sai-ydev/phd_HAT/PhD_HAT.brd

## EAGLE design PhD_HAT.brd (2019-10-11)

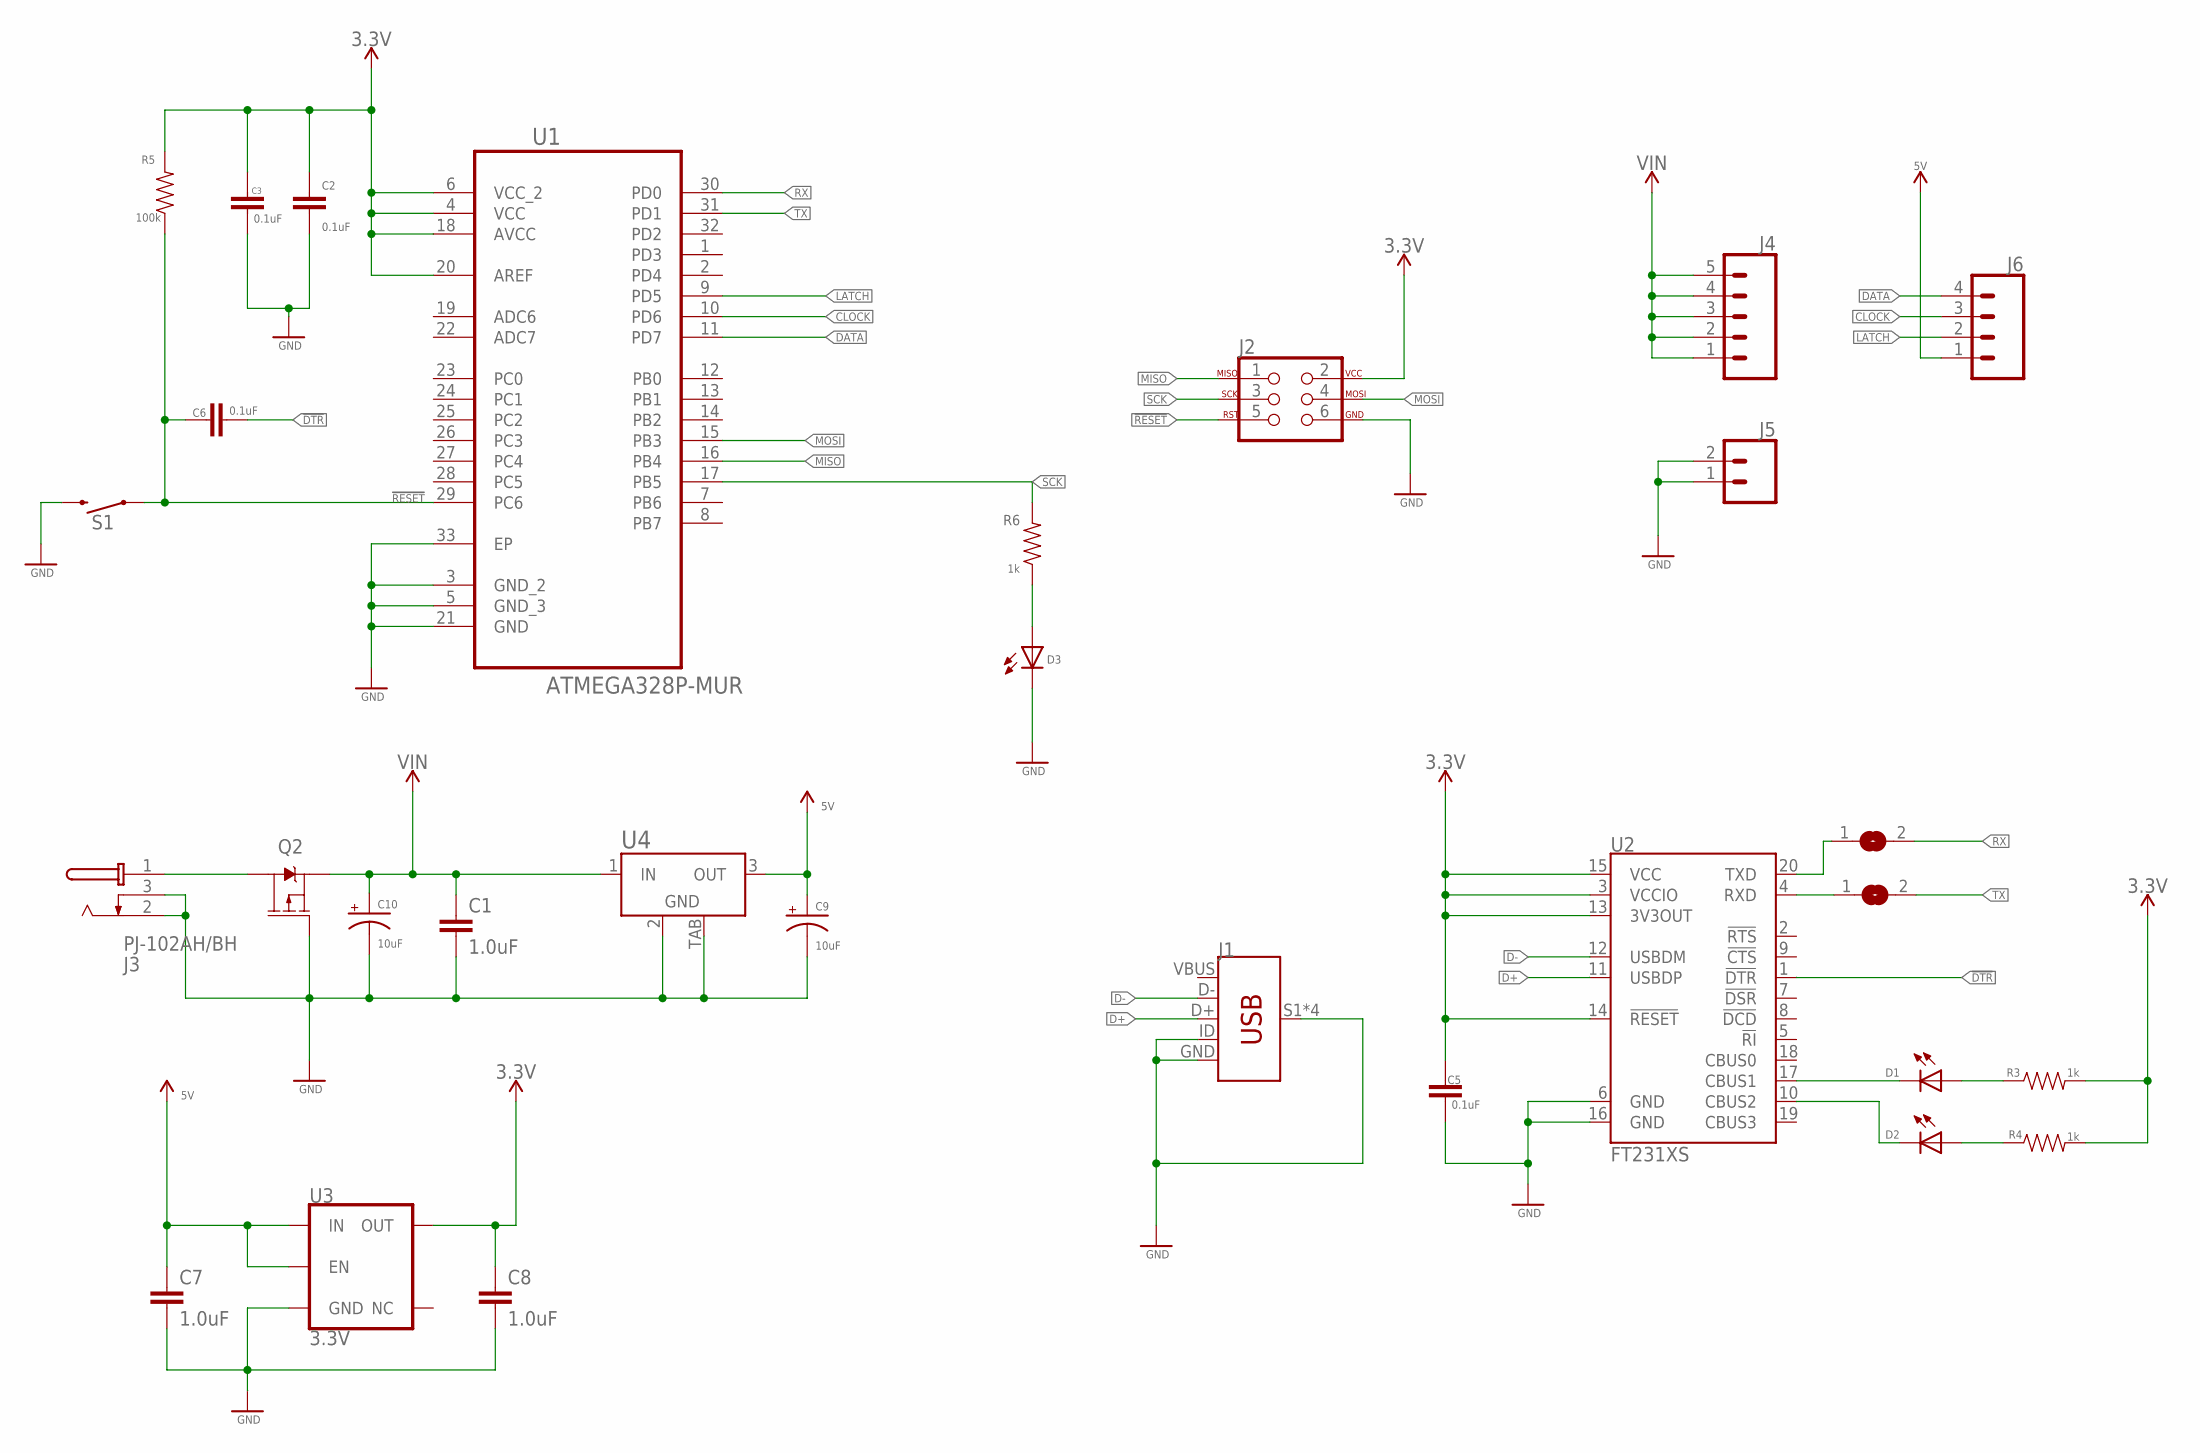
[picture p1: schematic PhD_HAT.sch, sheet 1]

Parts:
C1, C7, C8: 1.0uF; 0603
C2, C3, C5, C6: 0.1uF; 0603
C9, C10: 10uF; EIA3216
D1, D2, D3: LEDCHIP-LED0603; CHIP-LED0603
J1: USB_MINI-B_SMT; USB-MINIB
J2: AVR_SPI_PROG_3X2PTH; 2X3
J3: PJ-102AH/BH; PJ-102XH
J4: CONN_05SCREW; SCREWTERMINAL-3.5MM-5
J5: CONN_023.5MM; SCREWTERMINAL-3.5MM-2
J6: CONN_04SCREW; SCREWTERMINAL-3.5MM-4
Q2: 2.5A/30V/105mΩ; SOT23-3
R3, R4, R6: 1k; 0603
R5: 100k; 0603
S1: MOMENTARY-SWITCH-SPST-PTH-6.0MM; TACTILE_SWITCH_PTH_6.0MM
SJ1, SJ2: MICROBUILDER_SOLDERJUMPERREFLOW; MICROBUILDER_SOLDERJUMPER_REFLOW
U1: ATMEGA328P-MUR; QFN50P500X500X100-33N
U2: FT231XS; SSOP20_L
U3: 3.3V; SOT23-5
U4: MIC39100-5.0WS; SOT223

Connections:
3.3V: C2.1, C3.1, C5.1, C8.1, J2.2, R3.2, R4.2, R5.2, U1.4 (VCC), U1.6 (VCC_2), U1.18 (AVCC), U1.20 (AREF), U2.3 (VCCIO), U2.13 (3V3OUT), U2.14 (!RESET), U2.15 (VCC), U3.5 (OUT)
5V: C7.1, C9.+, J6.1, U3.1 (IN), U3.3 (EN), U4.3 (OUT)
!DTR: C6.2, U2.1 (!DTR)
!RESET: C6.1, J2.5, R5.1, S1.1, U1.29 (PC6)
CLOCK: J6.3, U1.10 (PD6)
D+: J1.D+, U2.11 (USBDP)
D-: J1.D-, U2.12 (USBDM)
DATA: J6.4, U1.11 (PD7)
GND: C1.2, C2.2, C3.2, C5.2, C7.2, C8.2, C9.-, C10.-, D3.C, J1.GND, J1.ID, J1.S1 (SHIELD), J1.S2 (SHIELD), J1.S3 (SHIELD), J1.S4 (SHIELD), J2.6, J3.2 (S), J3.3 (SS), J5.1, J5.2, Q2.1 (G), S1.3 (2), U1.3 (GND_2), U1.5 (GND_3), U1.21 (GND), U1.33 (EP), U2.6 (GND), U2.16 (GND), U3.2 (GND), U4.2 (GND), U4.TAB (GND); also elsewhere on the board
LATCH: J6.2, U1.9 (PD5)
MISO: J2.1, U1.16 (PB4)
MOSI: J2.4, U1.15 (PB3)
unnamed: D1.C, U2.17 (CBUS1)
unnamed: D2.C, U2.10 (CBUS2)
unnamed: D1.A, R3.1
unnamed: D2.A, R4.1
unnamed: D3.A, R6.1
unnamed: SJ1.1, U2.4 (RXD)
unnamed: SJ2.1, U2.20 (TXD)
unnamed: J3.1 (T), Q2.3 (D)
RX: SJ2.2, U1.30 (PD0); also elsewhere on the board
SCK: J2.3, R6.2, U1.17 (PB5)
TX: SJ1.2, U1.31 (PD1); also elsewhere on the board
VBUS: J1.VBUS
VIN: C1.1, C10.+, J4.1, J4.2, J4.3, J4.4, J4.5, Q2.2 (S), U4.1 (IN)

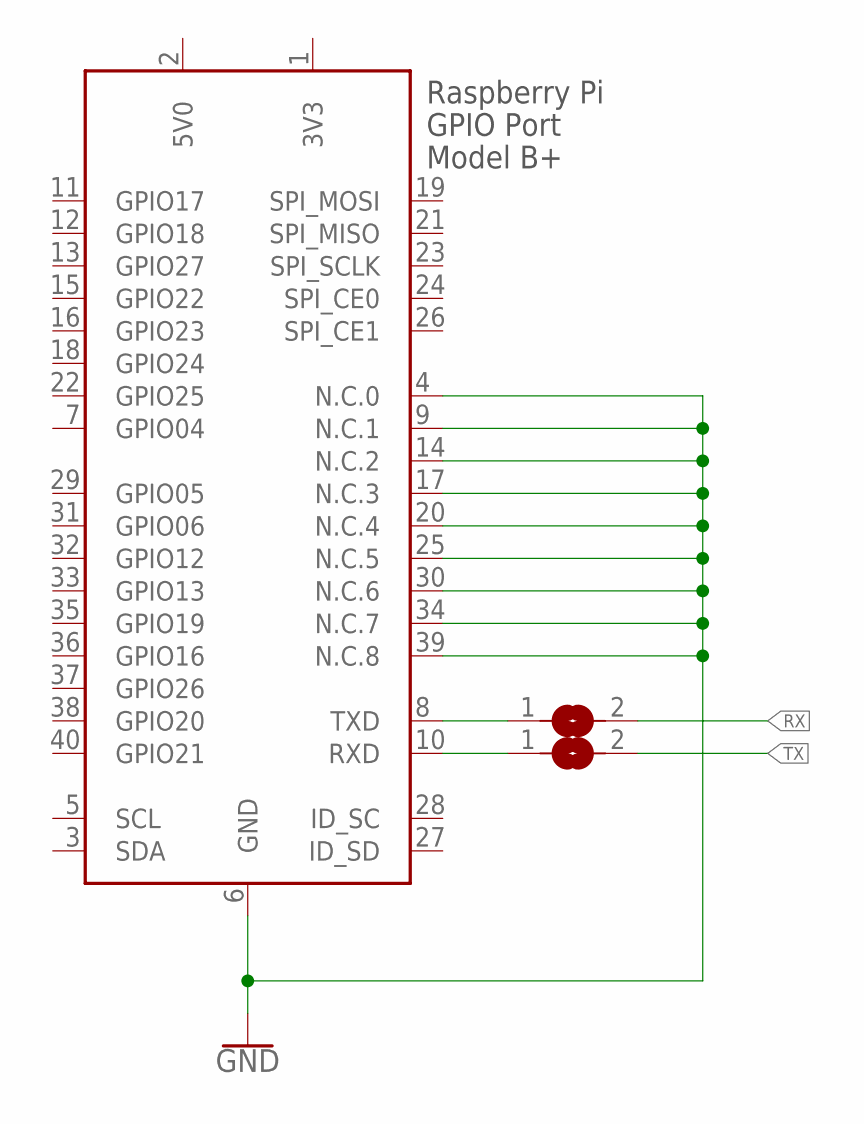
[picture p2: schematic PhD_HAT.sch, sheet 2]

Parts:
SJ3, SJ4: MICROBUILDER_SOLDERJUMPER; MICROBUILDER_SOLDERJUMPER_ARROW_NOPASTE
X1: RASPI_BOARD_B+_H; RASPI_BOARD_B+HAT

Connections:
3V3: X1.1 (3V3)
5V0: X1.2 (5V0)
GND: X1.4 (N.C.0), X1.6 (GND), X1.9 (N.C.1), X1.14 (N.C.2), X1.17 (N.C.3), X1.20 (N.C.4), X1.25 (N.C.5), X1.30 (N.C.6), X1.34 (N.C.7), X1.39 (N.C.8); also elsewhere on the board
unnamed: SJ3.1, X1.8 (TXD)
unnamed: SJ4.1, X1.10 (RXD)
RX: SJ3.2; also elsewhere on the board
TX: SJ4.2; also elsewhere on the board

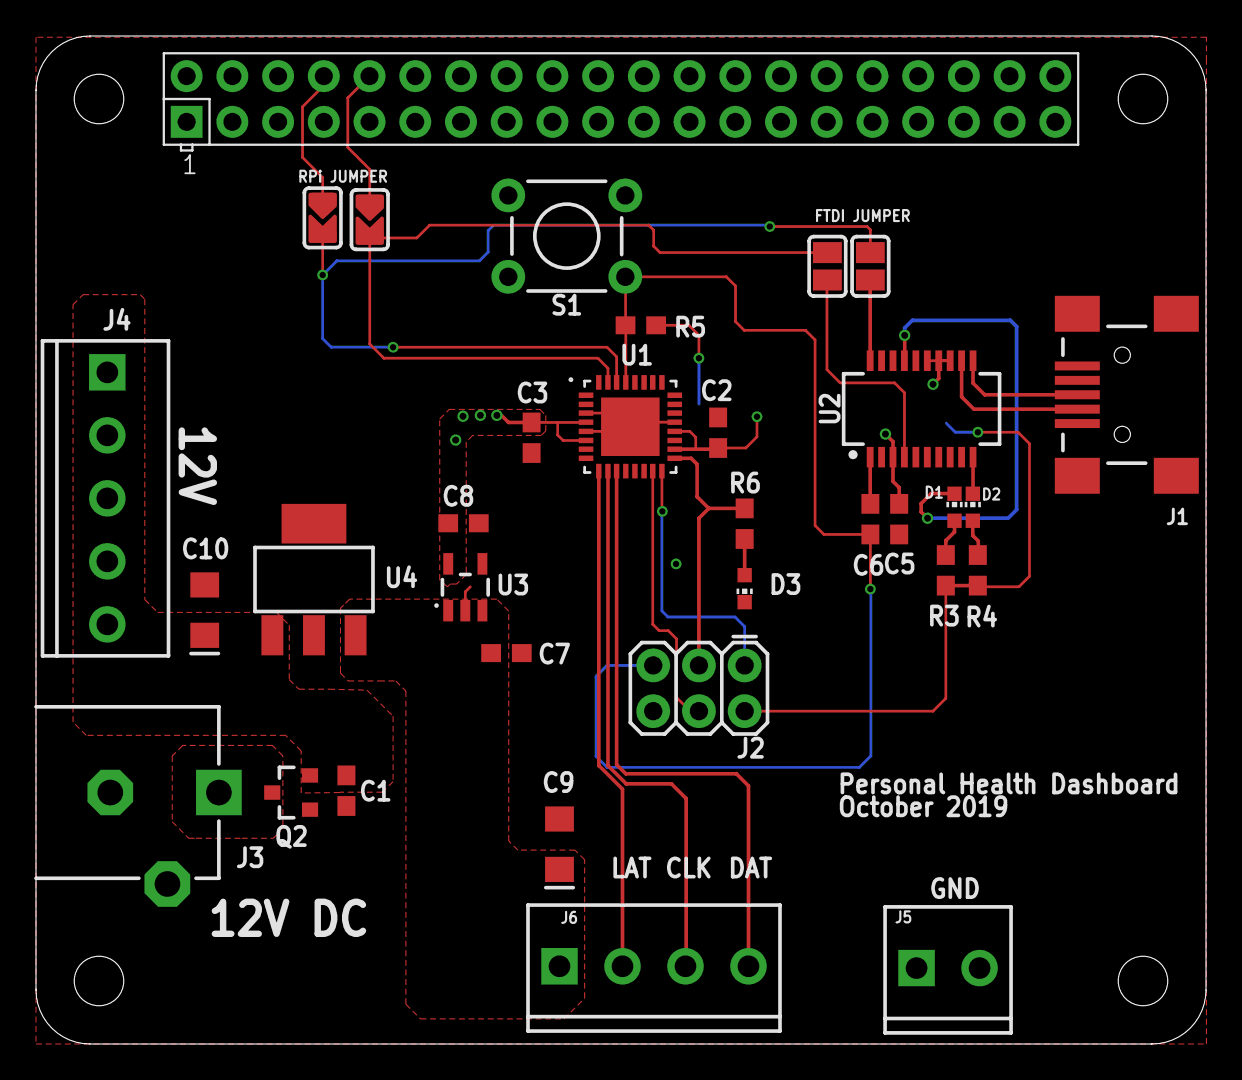
[picture p3: board PhD_HAT.brd from above]

Board: 2 copper layers, 65.0 x 56.0 mm, 33 parts (0 on the bottom side), 26 nets.
