sai-ydev/phd_HAT/PhD_HAT_Pi.brd

## EAGLE design PhD_HAT_Pi.brd (2019-10-04)

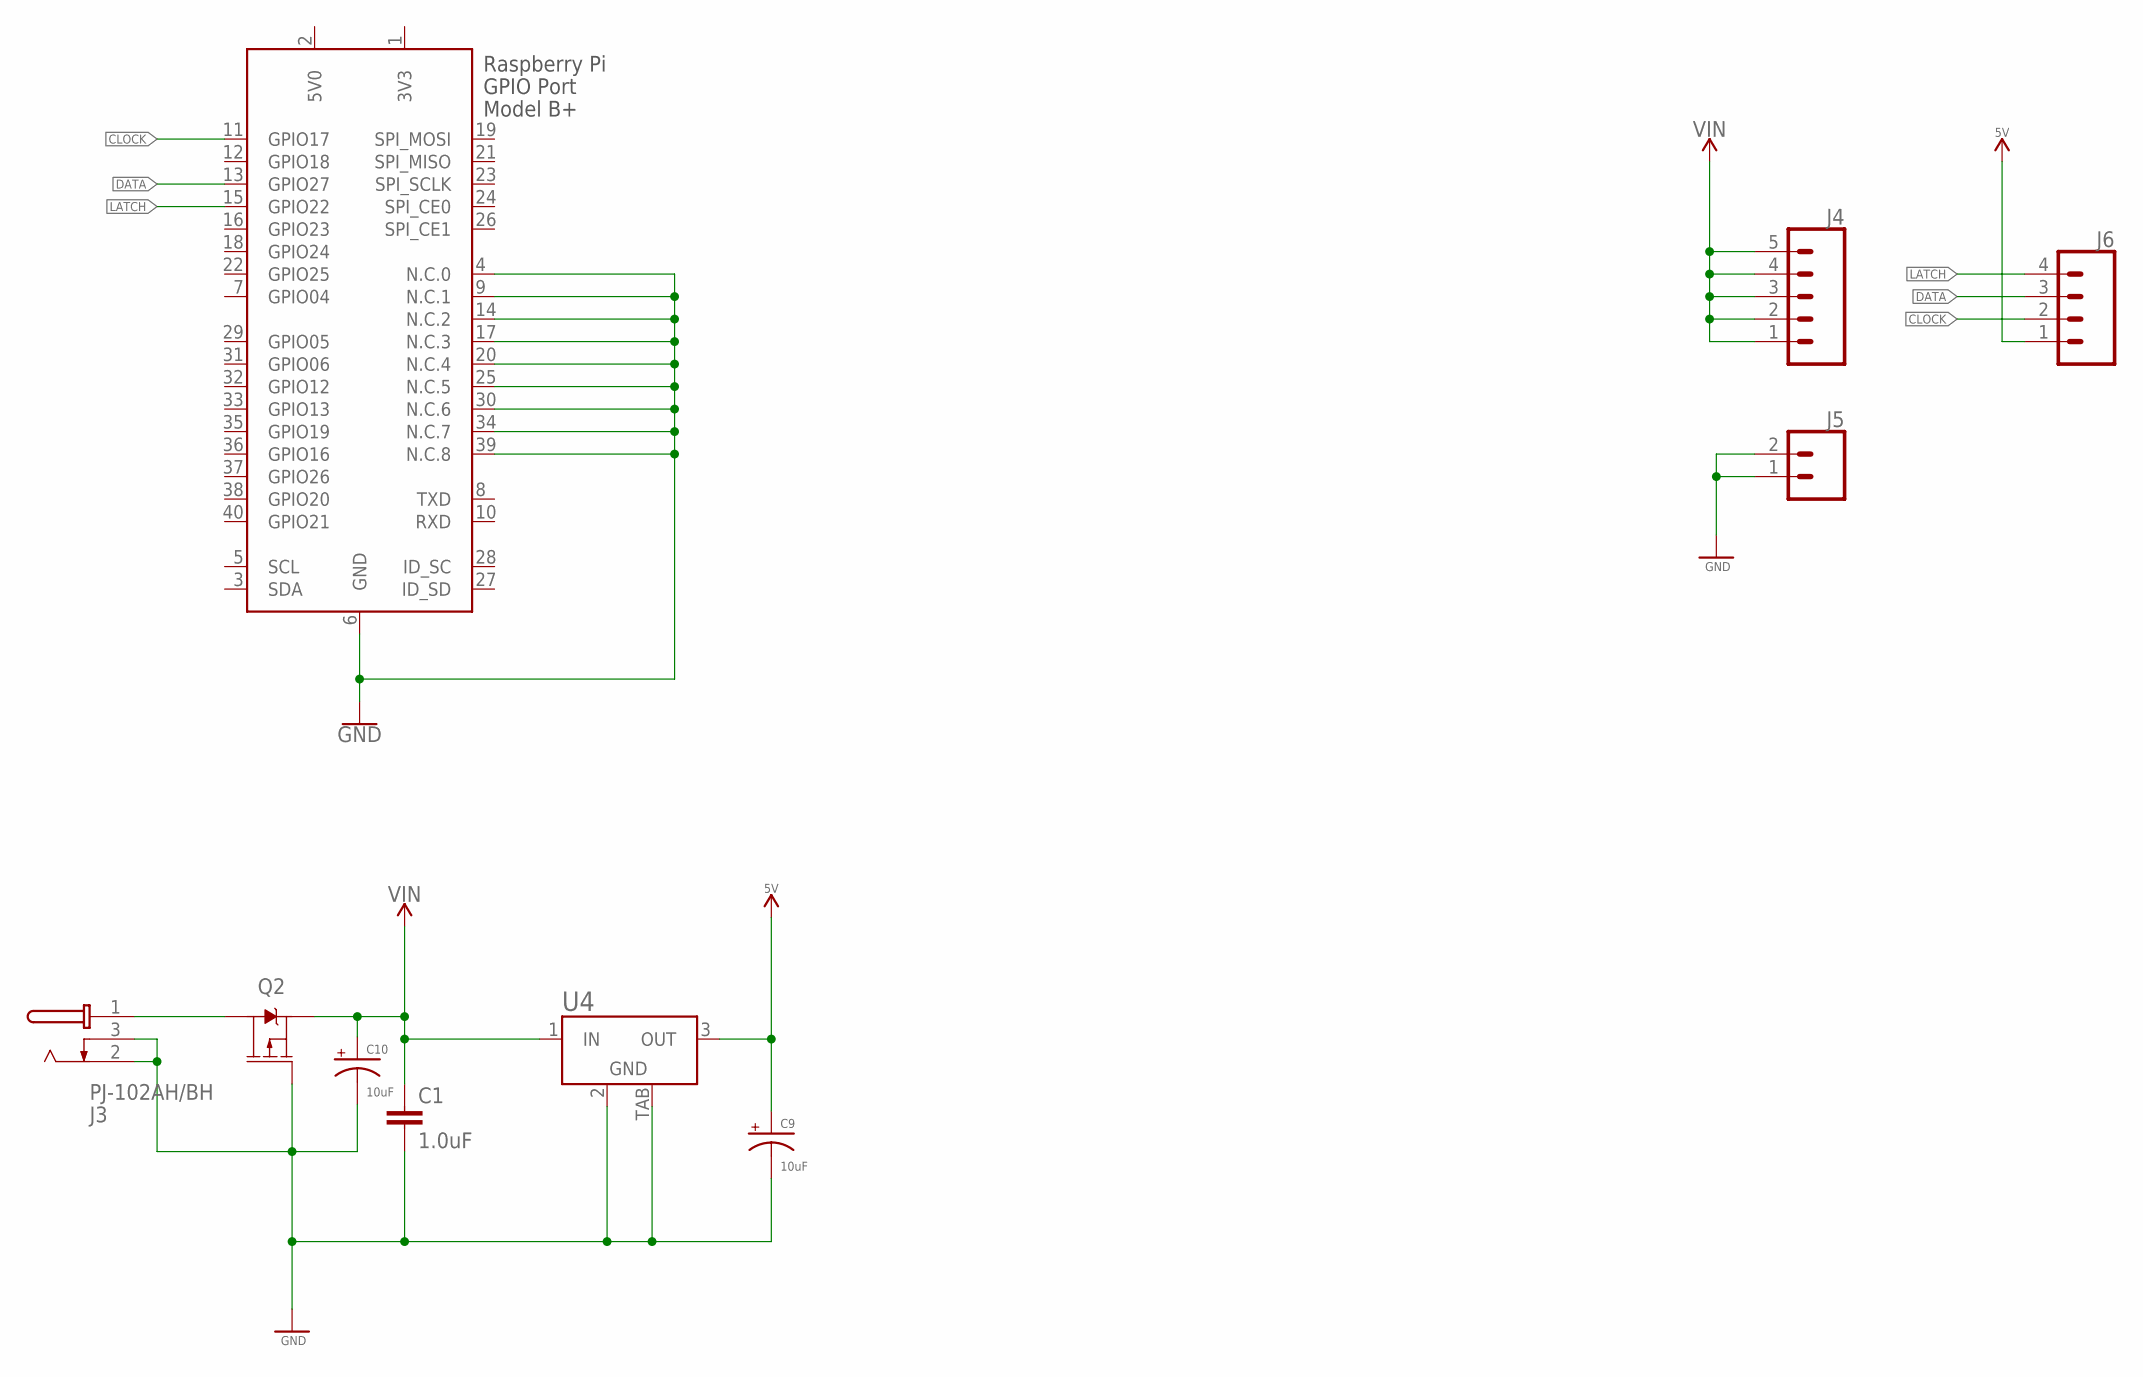
[picture p4: schematic PhD_HAT_Pi.sch, sheet 1]

Parts:
C1: 1.0uF; 0603
C9, C10: 10uF; EIA3216
J3: PJ-102AH/BH; PJ-102XH
J4: CONN_05SCREW; SCREWTERMINAL-3.5MM-5
J5: CONN_023.5MM; SCREWTERMINAL-3.5MM-2
J6: CONN_04SCREW; SCREWTERMINAL-3.5MM-4
Q2: 2.5A/30V/105mΩ; SOT23-3
U4: MIC39100-5.0WS; SOT223
X1: RASPI_BOARD_B+_H; RASPI_BOARD_B+HAT

Connections:
3V3: X1.1 (3V3)
5V: C9.+, J6.1, U4.3 (OUT)
5V0: X1.2 (5V0)
CLOCK: J6.2, X1.11 (GPIO17)
DATA: J6.3, X1.13 (GPIO27)
GND: C1.2, C9.-, C10.-, J3.2 (S), J3.3 (SS), J5.1, J5.2, Q2.1 (G), U4.2 (GND), U4.TAB (GND), X1.4 (N.C.0), X1.6 (GND), X1.9 (N.C.1), X1.14 (N.C.2), X1.17 (N.C.3), X1.20 (N.C.4), X1.25 (N.C.5), X1.30 (N.C.6), X1.34 (N.C.7), X1.39 (N.C.8)
LATCH: J6.4, X1.15 (GPIO22)
unnamed: J3.1 (T), Q2.3 (D)
VIN: C1.1, C10.+, J4.1, J4.2, J4.3, J4.4, J4.5, Q2.2 (S), U4.1 (IN)

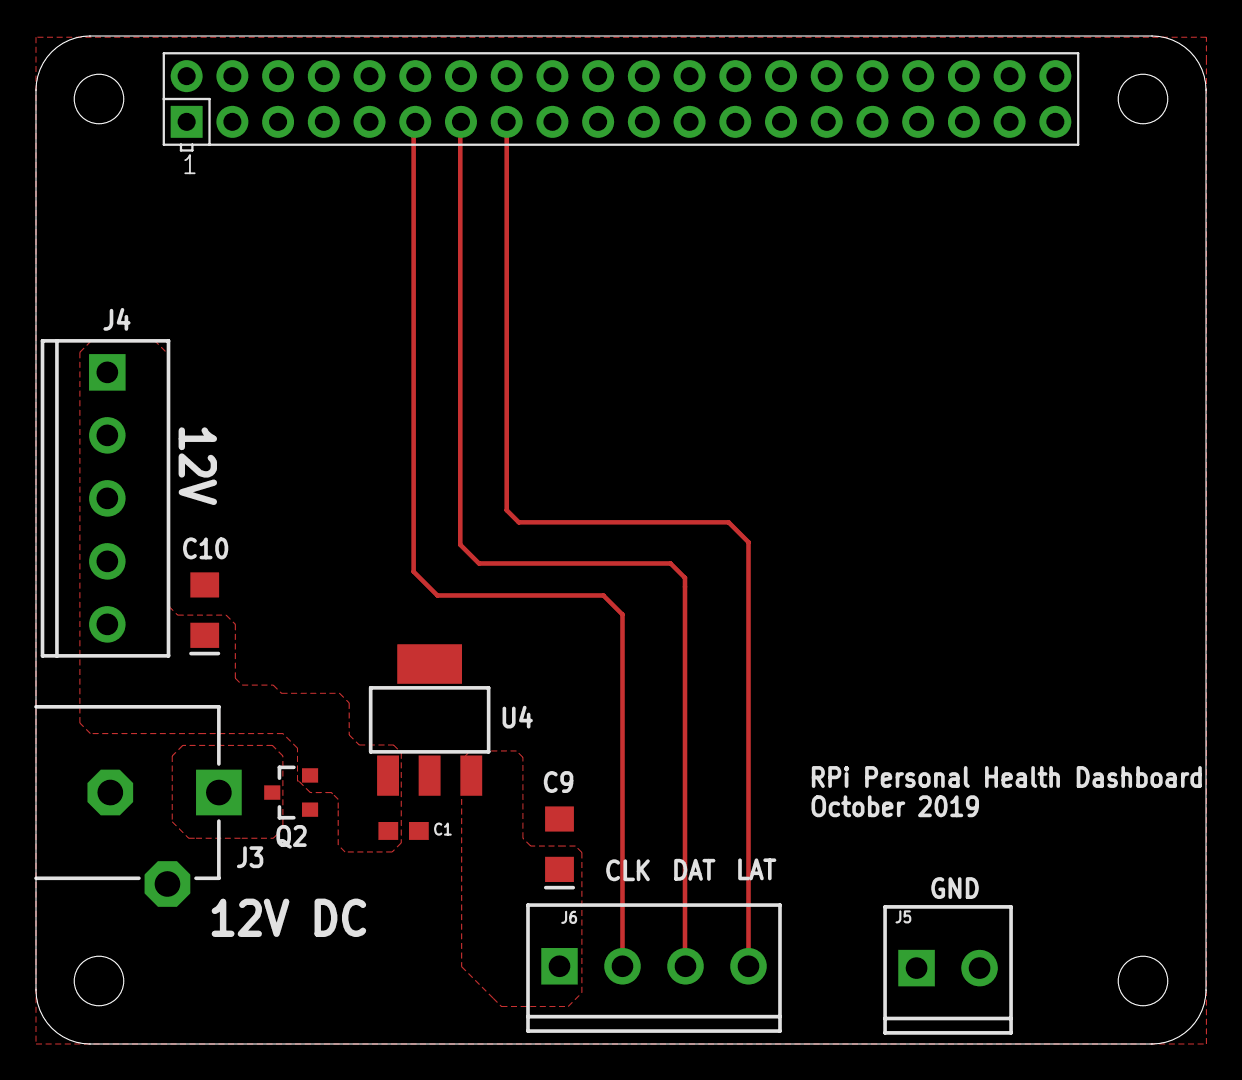
[picture p5: board PhD_HAT_Pi.brd from above]

Board: 2 copper layers, 65.0 x 56.0 mm, 10 parts (0 on the bottom side), 7 nets.
