sai-ydev/phd_HAT/(commit log)

2019-09-26 Checkin- version
    [PhD_HAT.brd, PhD_HAT.sch]
2019-09-30 Check-in of design files
    A partial check-in to switch laptops
    [PhD_HAT.brd, PhD_HAT.sch]
2019-09-30 check -in
    [PhD_HAT.brd, PhD_HAT.sch]
2019-10-01 completed board file
    [PhD_HAT.brd]
2019-10-04 Checking in Raspberry Pi variant design
    [PhD_HAT_Pi.brd, PhD_HAT_Pi.sch]
2019-10-11 Change of power flow sequence
    The max input voltage for the 3.3V regulator is 6V. The design was originally designed to receive 12V. This smoked the regulator. Changed the design to receive input from a 5V regulator.
    [PhD_HAT.brd, PhD_HAT.sch]
