sai-ydev/phd_HAT/(notices)

Notices in the files:
parts and their libraries:
SparkFun-Capacitors: Licensing: Creative Commons ShareAlike 4.0 International - https://creativecommons.org/licenses/by-sa/4.0
con-cuistack: Copyright (C) 2008, Bob Starr
